mfacton/brush-can/README.md

# brush-can
Dense triple brushed motor controller with CAN FD
