mfacton/brush-can/pcb/brush-can.kicad_pcb

## KiCad design pcb/brush-can.kicad_pcb (2024-08-17)

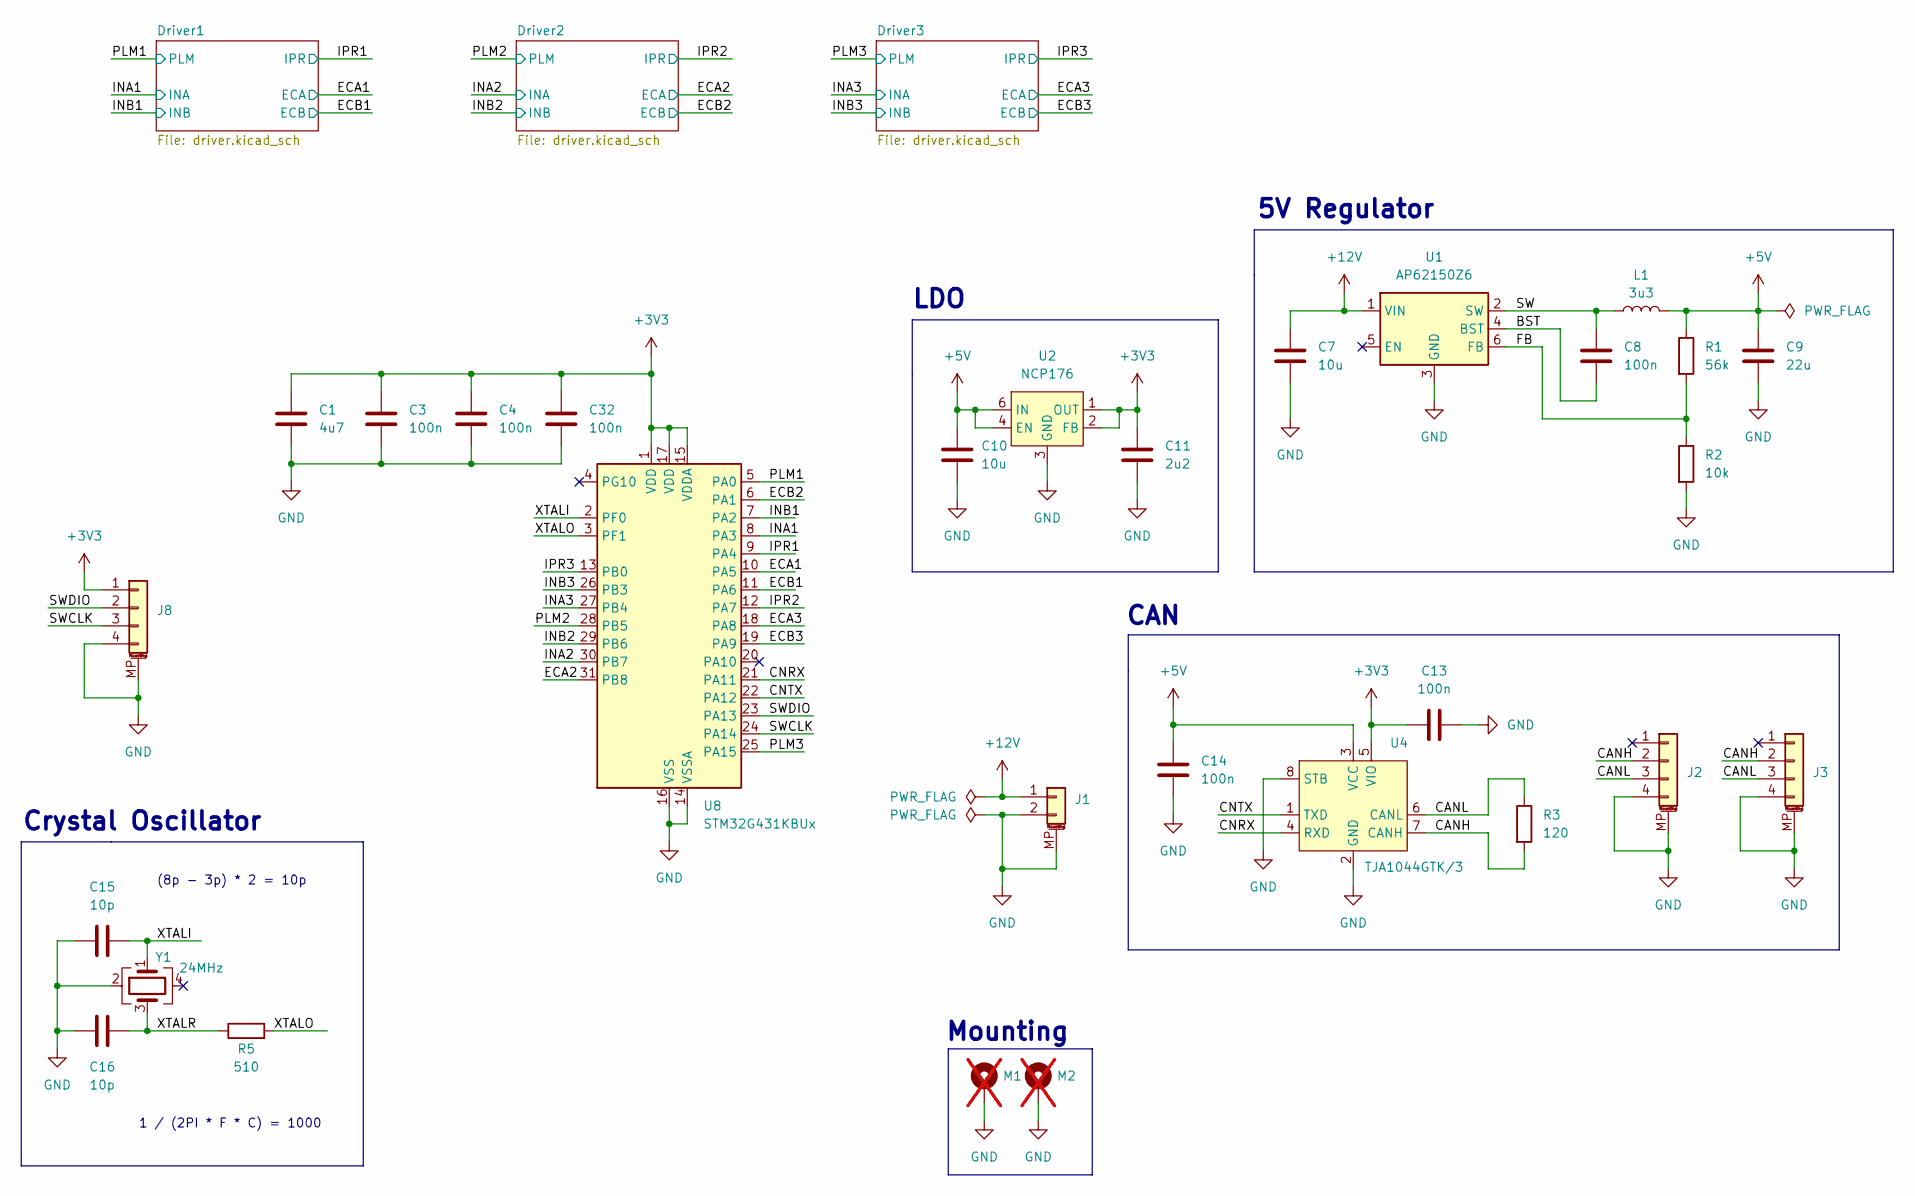
[picture p1: schematic brush-can.kicad_sch]

Parts:
C1: 4u7; C_0402_1005Metric; LCSC C23733
C3, C4, C8, C13, C14, C32: 100n; C_0402_1005Metric; LCSC C1525
C7: 10u; C_0603_1608Metric; LCSC C96446
C9: 22u; C_0805_2012Metric; LCSC C45783
C10: 10u; C_0603_1608Metric; LCSC C19702
C11: 2u2; C_0402_1005Metric; LCSC C12530
C15, C16: 10p; C_0402_1005Metric; LCSC C32949
J1: Conn_01x02_MountingPin; JST_GH_SM02B-GHS-TB_1x02-1MP_P1.25mm_Horizontal; LCSC C189893
J2, J3: Conn_01x04_MountingPin; JST_GH_SM04B-GHS-TB_1x04-1MP_P1.25mm_Horizontal; LCSC C189895
J8: Conn_01x04_MountingPin; JST_SH_BM04B-SRSS-TB_1x04-1MP_P1.00mm_Vertical; LCSC C160390
L1: 3u3; L_Chilisin_BMRA00040420; LCSC C207829
M1, M2: 24939; not fitted
R1: 56k; R_0402_1005Metric; LCSC C25796
R2: 10k; R_0402_1005Metric; LCSC C25744
R3: 120; R_1206_3216Metric_Pad1.30x1.75mm_HandSolder; LCSC C17909
R5: 510; R_0402_1005Metric; LCSC C25123
U1: AP62150Z6; SOT-563; LCSC C3193206
U2: NCP176; DFN-6-1EP_1.2x1.2mm_P0.4mm_EP0.3x0.94mm_PullBack; LCSC C233363
U4: TJA1044GTK/3; HVSON-8-1EP_3x3mm_P0.65mm_EP1.6x2.4mm; LCSC C2157795
U8: STM32G431KBUx; QFN-32-1EP_5x5mm_P0.5mm_EP3.45x3.45mm; LCSC C1341901
Y1: 24MHz; Crystal_SMD_1612-4P; LCSC C2929397

Connections:
+3V3: C1.1, C3.1, C4.1, C11.1, C13.1, C32.1, J8.1, U2.1 (OUT), U2.2 (FB), U4.5 (VIO), U8.1 (VDD), U8.15 (VDDA), U8.17 (VDD); also elsewhere on the board
+5V: C9.1, C10.1, C14.2, L1.2, R1.1, U2.4 (EN), U2.6 (IN), U4.3 (VCC)
+12V: C7.1, J1.1, U1.1 (VIN); also elsewhere on the board
/BST: C8.2, U1.4 (BST)
/CANH: J2.2, J3.2, R3.2, U4.7 (CANH)
/CANL: J2.3, J3.3, R3.1, U4.6 (CANL)
/CNRX: U4.4 (RXD), U8.21 (PA11)
/CNTX: U4.1 (TXD), U8.22 (PA12)
/ECA1: U8.10 (PA5); also elsewhere on the board
/ECA2: U8.31 (PB8); also elsewhere on the board
/ECA3: U8.18 (PA8); also elsewhere on the board
/ECB1: U8.11 (PA6); also elsewhere on the board
/ECB2: U8.6 (PA1); also elsewhere on the board
/ECB3: U8.19 (PA9); also elsewhere on the board
/FB: R1.2, R2.1, U1.6 (FB)
/INA1: U8.8 (PA3); also elsewhere on the board
/INA2: U8.30 (PB7); also elsewhere on the board
/INA3: U8.27 (PB4); also elsewhere on the board
/INB1: U8.7 (PA2); also elsewhere on the board
/INB2: U8.29 (PB6); also elsewhere on the board
/INB3: U8.26 (PB3); also elsewhere on the board
/IPR1: U8.9 (PA4); also elsewhere on the board
/IPR2: U8.12 (PA7); also elsewhere on the board
/IPR3: U8.13 (PB0); also elsewhere on the board
/PLM1: U8.5 (PA0); also elsewhere on the board
/PLM2: U8.28 (PB5); also elsewhere on the board
/PLM3: U8.25 (PA15); also elsewhere on the board
/SW: C8.1, L1.1, U1.2 (SW)
/SWCLK: J8.3, U8.24 (PA14)
/SWDIO: J8.2, U8.23 (PA13)
/XTALI: C15.2, U8.2 (PF0), Y1.1
/XTALO: R5.2, U8.3 (PF1)
/XTALR: C16.2, R5.1, Y1.3
GND: C1.2, C3.2, C4.2, C7.2, C9.2, C10.2, C11.2, C13.2, C14.1, C15.1, C16.1, C32.2, J1.2, J1.MP (MountPin), J2.4, J2.MP (MountPin), J3.4, J3.MP (MountPin), J8.4, J8.MP (MountPin), M1.MP, M2.MP, R2.2, U1.3 (GND), U2.3 (GND), U2.7 (EPAD), U4.2 (GND), U4.8 (STB), U4.9 (EPAD), U8.14 (VSSA), U8.16 (VSS), U8.32 (VSS), U8.33 (VSS), Y1.2; also elsewhere on the board

Notes on the sheet:
CAN
Mounting
5V Regulator
(8p - 3p) * 2 = 10p
LDO
Crystal Oscillator
1 / (2PI * F * C) = 1000

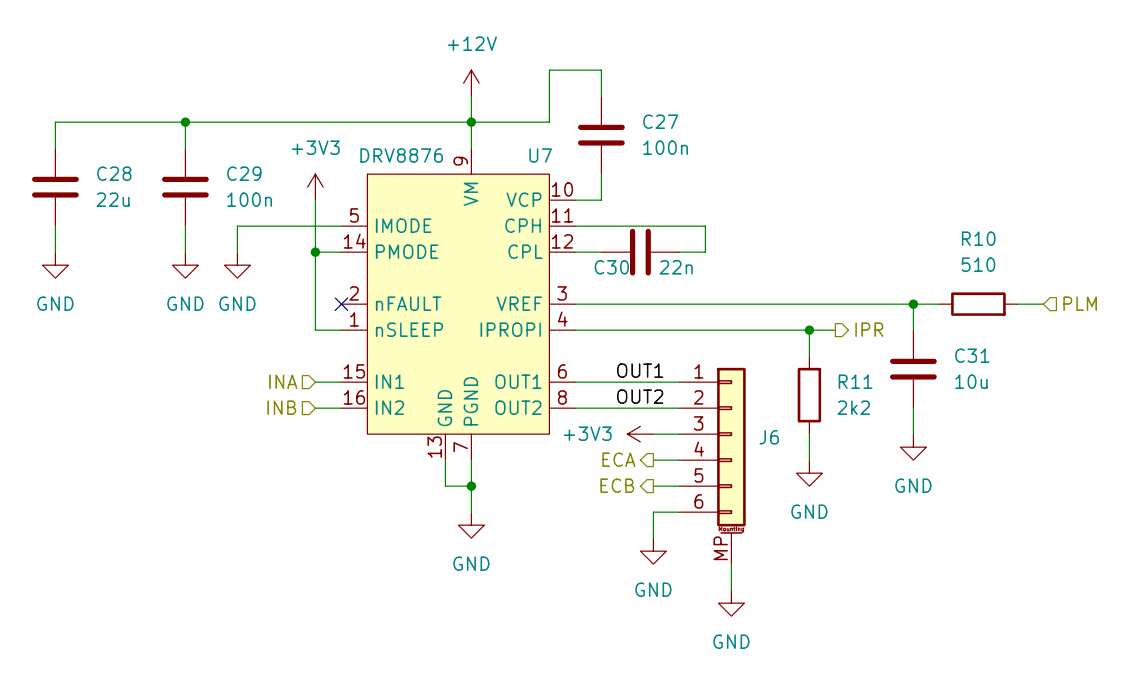
[picture p2: schematic driver.kicad_sch]

Parts:
C27, C29: 100n; C_0402_1005Metric; LCSC C307331
C28: 22u; C_1206_3216Metric; LCSC C12891
C30: 22n; C_0402_1005Metric; LCSC C1532
C31: 10u; C_0402_1005Metric; LCSC C15525
J6: Conn_01x06_MountingPin; JST_SH_SM06B-SRSS-TB_1x06-1MP_P1.00mm_Horizontal; LCSC C160405
R10: 510; R_0402_1005Metric; LCSC C25123
R11: 2k2; R_0402_1005Metric; LCSC C25879
U7: DRV8876; QFN-16-1EP_3x3mm_P0.5mm_EP1.7x1.7mm_ThermalVias; LCSC C1852100

Connections:
+3V3: J6.3, U7.1 (nSLEEP), U7.14 (PMODE); also elsewhere on the board
+12V: C27.1, C28.1, C29.1, U7.9 (VM); also elsewhere on the board
/Driver3/OUT1: J6.1, U7.6 (OUT1)
/Driver3/OUT2: J6.2, U7.8 (OUT2)
/ECA3: J6.4; also elsewhere on the board
/ECB3: J6.5; also elsewhere on the board
/INA3: U7.15 (IN1); also elsewhere on the board
/INB3: U7.16 (IN2); also elsewhere on the board
/IPR3: R11.2, U7.4 (IPROPI); also elsewhere on the board
/PLM3: R10.2; also elsewhere on the board
GND: C28.2, C29.2, C31.2, J6.6, J6.MP (MountPin), R11.1, U7.5 (IMODE), U7.7 (PGND), U7.13 (GND), U7.17 (PAD); also elsewhere on the board
unnamed: C30.1, U7.11 (CPH)
unnamed: C30.2, U7.12 (CPL)
unnamed: C27.2, U7.10 (VCP)
unnamed: C31.1, R10.1, U7.3 (VREF)

Parts of its further copies:
C17, C19, C22, C24: 100n; C_0402_1005Metric; LCSC C307331
C18, C23: 22u; C_1206_3216Metric; LCSC C12891
C20, C25: 22n; C_0402_1005Metric; LCSC C1532
C21, C26: 10u; C_0402_1005Metric; LCSC C15525
J4, J5: Conn_01x06_MountingPin; JST_SH_SM06B-SRSS-TB_1x06-1MP_P1.00mm_Horizontal; LCSC C160405
R6, R8: 510; R_0402_1005Metric; LCSC C25123
R7, R9: 2k2; R_0402_1005Metric; LCSC C25879
U5, U6: DRV8876; QFN-16-1EP_3x3mm_P0.5mm_EP1.7x1.7mm_ThermalVias; LCSC C1852100

Connections of its further copies:
+3V3: J4.3, J5.3, U5.1 (nSLEEP), U5.14 (PMODE), U6.1 (nSLEEP), U6.14 (PMODE); also elsewhere on the board
+12V: C17.1, C18.1, C19.1, C22.1, C23.1, C24.1, U5.9 (VM), U6.9 (VM); also elsewhere on the board
/Driver1/OUT1: J4.1, U5.6 (OUT1)
/Driver1/OUT2: J4.2, U5.8 (OUT2)
/Driver2/OUT1: J5.1, U6.6 (OUT1)
/Driver2/OUT2: J5.2, U6.8 (OUT2)
/ECA1: J4.4; also elsewhere on the board
/ECA2: J5.4; also elsewhere on the board
/ECB1: J4.5; also elsewhere on the board
/ECB2: J5.5; also elsewhere on the board
/INA1: U5.15 (IN1); also elsewhere on the board
/INA2: U6.15 (IN1); also elsewhere on the board
/INB1: U5.16 (IN2); also elsewhere on the board
/INB2: U6.16 (IN2); also elsewhere on the board
/IPR1: R7.2, U5.4 (IPROPI); also elsewhere on the board
/IPR2: R9.2, U6.4 (IPROPI); also elsewhere on the board
/PLM1: R6.2; also elsewhere on the board
/PLM2: R8.2; also elsewhere on the board
GND: C18.2, C19.2, C21.2, C23.2, C24.2, C26.2, J4.6, J4.MP (MountPin), J5.6, J5.MP (MountPin), R7.1, R9.1, U5.5 (IMODE), U5.7 (PGND), U5.13 (GND), U5.17 (PAD), U6.5 (IMODE), U6.7 (PGND), U6.13 (GND), U6.17 (PAD); also elsewhere on the board
unnamed: C20.1, U5.11 (CPH)
unnamed: C20.2, U5.12 (CPL)
unnamed: C17.2, U5.10 (VCP)
unnamed: C21.1, R6.1, U5.3 (VREF)
unnamed: C25.1, U6.11 (CPH)
unnamed: C25.2, U6.12 (CPL)
unnamed: C22.2, U6.10 (VCP)
unnamed: C26.1, R8.1, U6.3 (VREF)

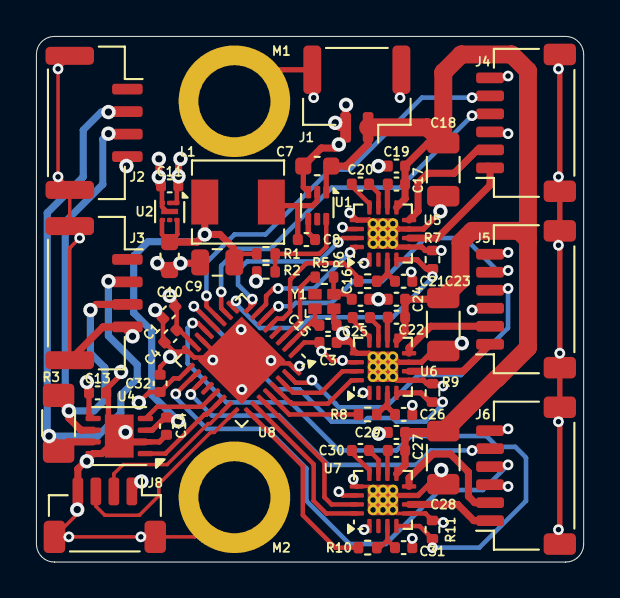
[picture p3: board brush-can.kicad_pcb from above]

Board: 4 copper layers, 30.4 x 29.2 mm, 56 parts (0 on the bottom side), 52 nets.
