mfacton/brush-can/firmware/brush-can/brush-can.ioc

Mcu.UserName=STM32G431KBUx
PA0.Signal=S_TIM2_CH1
PA1.GPIO_Label=ECB2
PA1.Signal=GPIO_Input
PA11.Signal=FDCAN1_RX
PA12.Signal=FDCAN1_TX
PA13.Signal=SYS_JTMS-SWDIO
PA14.Signal=SYS_JTCK-SWCLK
PA15.Signal=S_TIM8_CH1
PA2.Signal=S_TIM2_CH3
PA3.Signal=S_TIM2_CH4
PA4.Signal=ADC2_IN17
PA5.GPIO_Label=ECA1
PA5.Signal=GPIO_Input
PA6.GPIO_Label=ECB1
PA6.Signal=GPIO_Input
PA7.Signal=ADC2_IN4
PA8.GPIO_Label=ECA3
PA8.Signal=GPIO_Input
PA9.GPIO_Label=ECB3
PA9.Signal=GPIO_Input
PB0.Signal=ADC1_IN15
PB3.Signal=S_TIM2_CH2
PB4.Signal=S_TIM3_CH1
PB5.Signal=S_TIM3_CH2
PB6.Signal=S_TIM4_CH1
PB7.Signal=S_TIM4_CH2
PB8-BOOT0.GPIO_Label=ECA2
PB8-BOOT0.Signal=GPIO_Input
PF0-OSC_IN.Signal=RCC_OSC_IN
PF1-OSC_OUT.Signal=RCC_OSC_OUT
