mfacton/brush-can/(commit log)

2024-06-05 Finish schematic
    [brush-can.kicad_pcb, brush-can.kicad_sch, brush3-can.kicad_pcb, brush3-can.kicad_sch, driver.kicad_sch]
2024-06-05 Random save
    [driver.kicad_sch]
2024-06-05 Rough layout of pcb
    [brush-can.kicad_pcb]
2024-06-06 Add inserts and change CAN connection
    [brush-can.kicad_pcb, brush-can.kicad_sch, driver.kicad_sch]
2024-06-07 Finish layout
    [brush-can.kicad_pcb, brush-can.kicad_sch]
2024-06-08 Wire most power
    [brush-can.kicad_pcb]
2024-06-10 Finish routing and rule checking
    [brush-can.kicad_pcb, brush-can.kicad_sch, driver.kicad_sch]
2024-06-10 Create production files
    [bom.csv, designators.csv, positions.csv]
2024-06-10 Finish final details
    [brush-can.kicad_pcb, brush-can.kicad_sch]
2024-06-10 Finish pin setup
2024-06-12 Final production
    [brush-can.kicad_pcb]
2024-06-12 Edit lcsc part number
    [brush-can.kicad_sch]
2024-07-19 Finish implementing PID
2024-08-17 Make revision 2
    [bom.csv, brush-can.kicad_pcb, brush-can.kicad_sch, designators.csv, driver.kicad_sch, positions.csv]
